Evan6678/Senior_Design_Project/SCADA_Diamond_Vault_Fixed.png

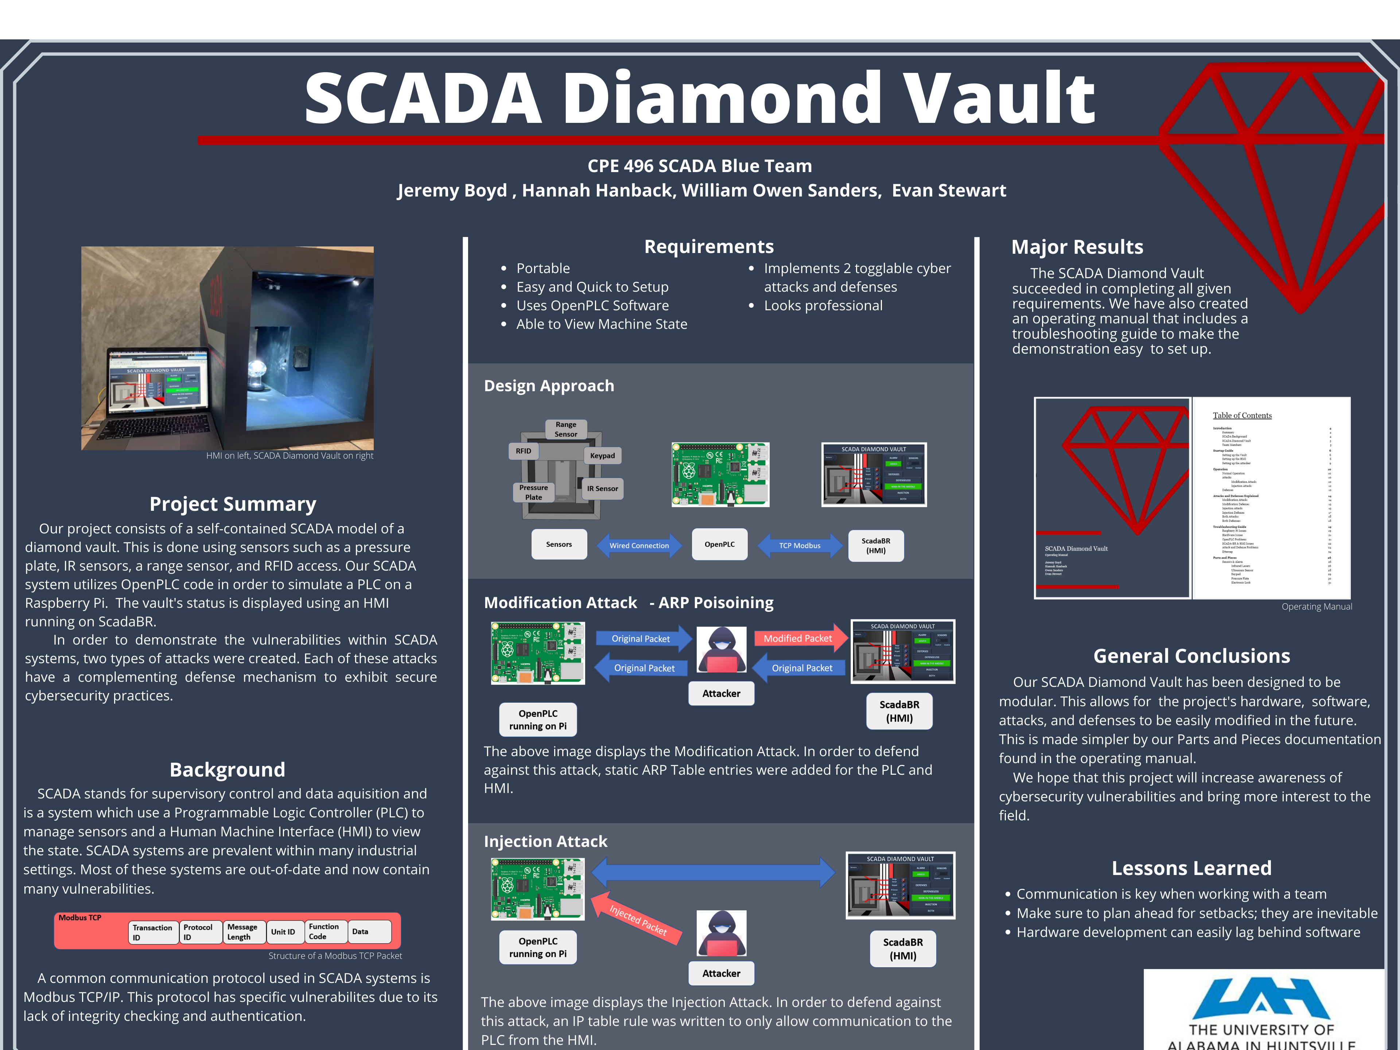
SCADA_Diamond_Vault_Fixed.png
